mattinglot/malenki-nano/hardware/README.md

Hardware
====

Production hardware is in malenki-nanoi/

Panels are in panel*/
