mattinglot/malenki-nano/hardware/holder/malenki-holder.FCStd

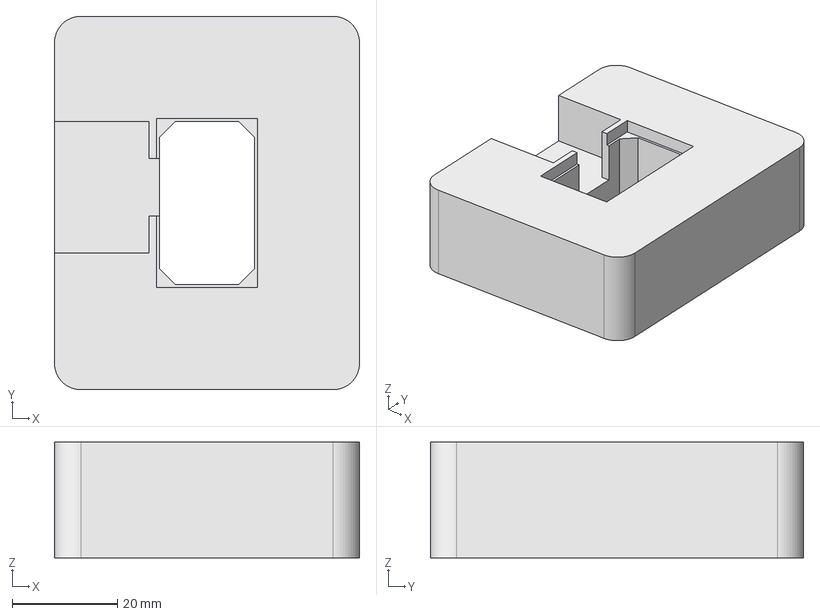
[picture p1: CAD file, 2024-02-17]
hardware/holder/malenki-holder.FCStd
58.0 x 71.0 x 22.0 mm
