mattinglot/malenki-nano/hardware/malenki-1616-3A/malenki-1616-3A.step

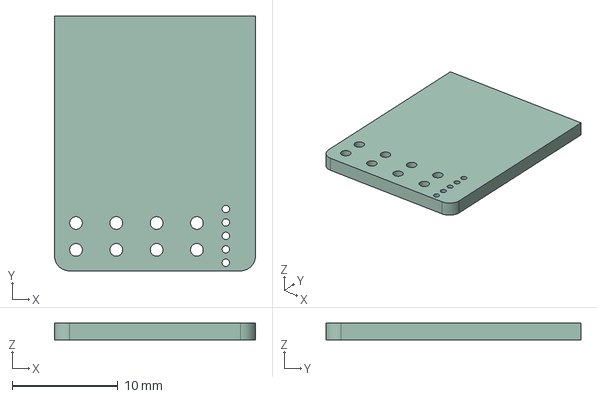
[picture p2: CAD file, 2024-01-25]
hardware/malenki-1616-3A/malenki-1616-3A.step
19.0 x 24.1 x 1.60 mm
