mattinglot/malenki-nano/(list of files, cad)

Other CAD files:
hardware/malenki-1616-3A/malenki-1616-3A.obj
