mattinglot/malenki-nano/hardware/malenki-1616-3A/change_log.md

# Design Revisions and Rationale

## 2202-08-27
Changes by: Matt Inglot

- Added XLR 0.1uF bypass caps between VM and GND on drivers per DRV8212P datasheet recommendations (p 26).
