mattinglot/malenki-nano/hardware/malenki-1616-3A/malenki-1616-3A.kicad_pcb

## KiCad design hardware/malenki-1616-3A/malenki-1616-3A.kicad_pcb (2024-01-25)

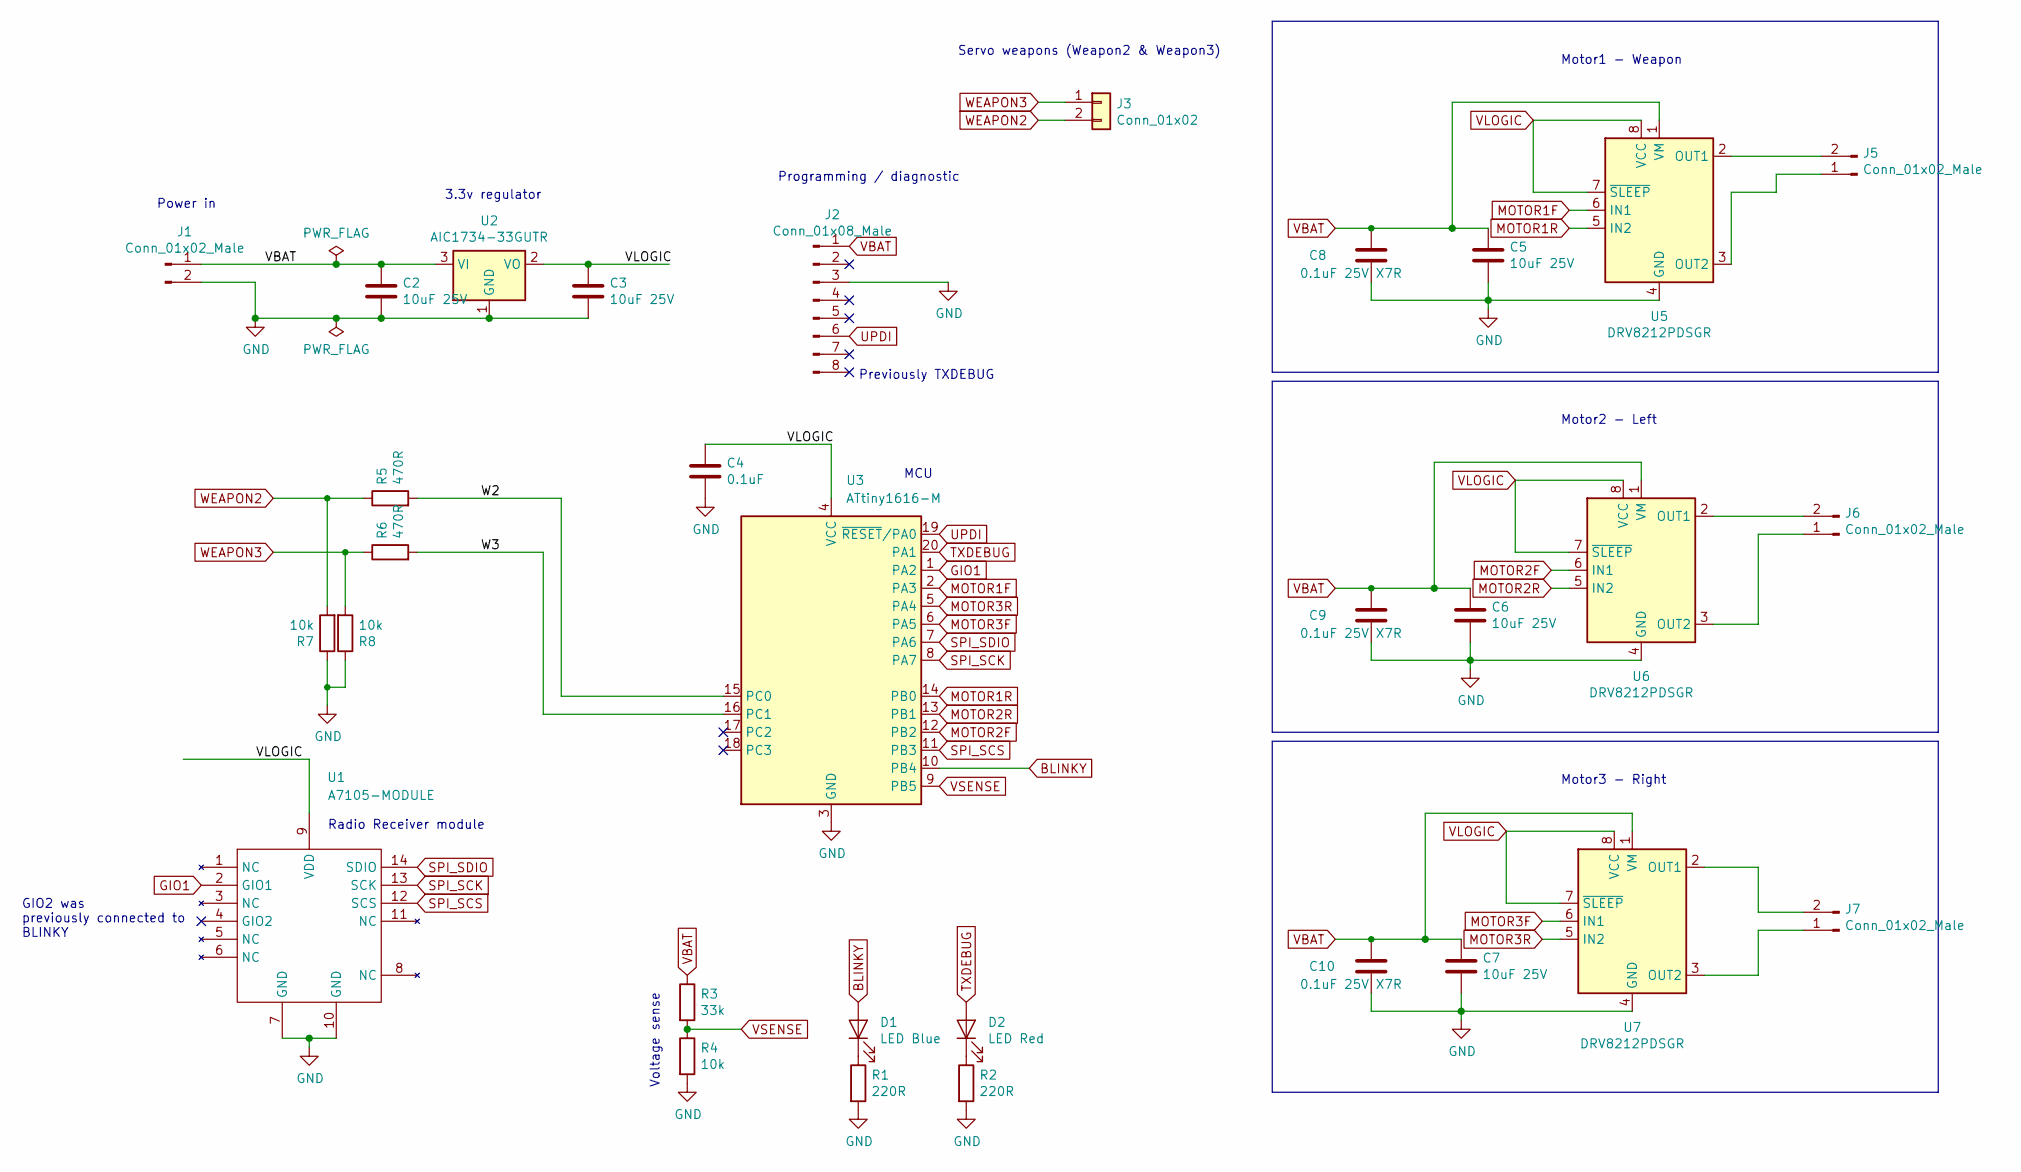
[picture p3: schematic malenki-1616-3A.kicad_sch, Malenki-Nano2]

Parts:
C2, C3, C5, C6, C7: 10uF 25V; C_0603_1608Metric; LCSC C2922482
C4: 0.1uF; C_0603_1608Metric; Partnum C14663; LCSC C14663
C8, C9, C10: 0.1uF 25V X7R; C_0603_1608Metric; LCSC C2922482
D1: LED Blue; LED_0805_2012Metric_Pad1.15x1.40mm_HandSolder; LCSC C2293
D2: LED Red; LED_0805_2012Metric_Pad1.15x1.40mm_HandSolder; LCSC C84256
J1, J5, J6, J7: Conn_01x02_Male; PinHeader_1x02_P2.54mm_BIG1
J2: Conn_01x08_Male; SOIC_clipProgSmall
J3: Conn_01x02; wirepad_2
R1, R2: 220R; R_0603_1608Metric; Partnum C22962; LCSC C22962
R3: 33k; R_0603_1608Metric; Partnum C4216; LCSC C4216
R4: 10k; R_0603_1608Metric; Partnum C25804; LCSC C25804
R5, R6: 470R; R_0402_1005Metric; LCSC C25117
R7, R8: 10k; R_0402_1005Metric; LCSC C25744
U1: A7105-MODULE; A7105-module
U2: AIC1734-33GUTR; SOT-23; Partnum C211659; LCSC C211659
U3: ATtiny1616-M; VQFN-20-1EP_3x3mm_P0.4mm_EP1.7x1.7mm; LCSC C507118
U5, U6, U7: DRV8212PDSGR; WSON-8-1EP_2x2mm_P0.5mm_HAND1; LCSC C39159

Connections:
/W2: R5.2, U3.15 (PC0)
/W3: R6.2, U3.16 (PC1)
BLINKY: D1.2 (A), U3.10 (PB4)
GIO1: U1.2 (GIO1), U3.1 (PA2)
GND: C2.2, C3.2, C4.2, C5.2, C6.2, C7.2, C8.2, C9.2, C10.2, J1.2, J2.3, R1.2, R2.2, R4.2, R7.1, R8.1, U1.7 (GND), U1.10 (GND), U2.1 (GND), U3.3 (GND), U3.21 (GND), U5.4 (GND), U5.9 (GND), U6.4 (GND), U6.9 (GND), U7.4 (GND), U7.9 (GND)
MOTOR1F: U3.2 (PA3), U5.6 (IN1)
MOTOR1R: U3.14 (PB0), U5.5 (IN2)
MOTOR2F: U3.12 (PB2), U6.6 (IN1)
MOTOR2R: U3.13 (PB1), U6.5 (IN2)
MOTOR3F: U3.6 (PA5), U7.6 (IN1)
MOTOR3R: U3.5 (PA4), U7.5 (IN2)
unnamed: D1.1 (K), R1.1
unnamed: D2.1 (K), R2.1
unnamed: J5.1, U5.3 (OUT2)
unnamed: J5.2, U5.2 (OUT1)
unnamed: J6.1, U6.3 (OUT2)
unnamed: J6.2, U6.2 (OUT1)
unnamed: J7.1, U7.3 (OUT2)
unnamed: J7.2, U7.2 (OUT1)
SPI_SCK: U1.13 (SCK), U3.8 (PA7)
SPI_SCS: U1.12 (SCS), U3.11 (PB3)
SPI_SDIO: U1.14 (SDIO), U3.7 (PA6)
TXDEBUG: D2.2 (A), U3.20 (PA1)
UPDI: J2.6, U3.19 (~RESET/PA0)
VBAT: C2.1, C5.1, C6.1, C7.1, C8.1, C9.1, C10.1, J1.1, J2.1, R3.1, U2.3 (VI), U5.1 (VM), U6.1 (VM), U7.1 (VM)
VLOGIC: C3.1, C4.1, U1.9 (VDD), U2.2 (VO), U3.4 (VCC), U5.7 (~SLEEP), U5.8 (VCC), U6.7 (~SLEEP), U6.8 (VCC), U7.7 (~SLEEP), U7.8 (VCC)
VSENSE: R3.2, R4.1, U3.9 (PB5)
WEAPON2: J3.2, R5.1, R7.2
WEAPON3: J3.1, R6.1, R8.2

Notes on the sheet:
Voltage sense
MCU
GIO2 was previously connected to BLINKY
3.3v regulator
Programming / diagnostic
Motor3 - Right
Servo weapons (Weapon2 & Weapon3)
Motor1 - Weapon
Motor2 - Left
Power in
Radio Receiver module
Previously TXDEBUG

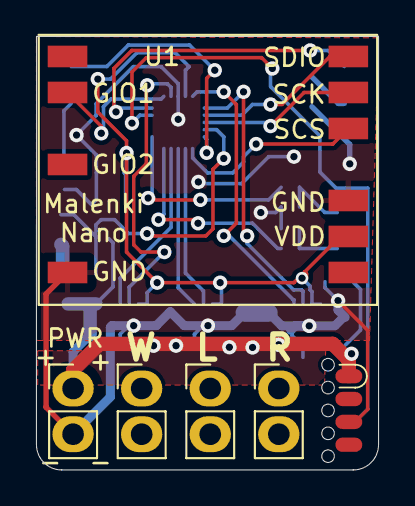
[picture p4: board malenki-1616-3A.kicad_pcb from above]

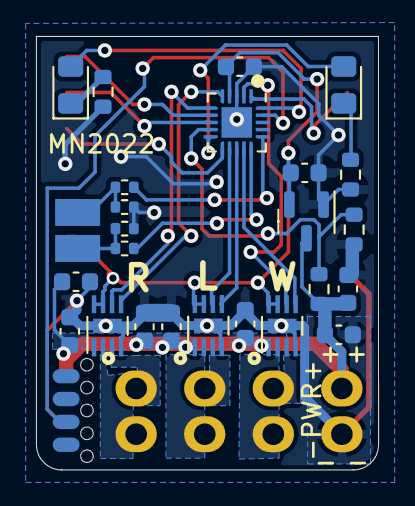
[picture p5: board malenki-1616-3A.kicad_pcb from below]

Board: 2 copper layers, 19.0 x 24.1 mm, 31 parts (25 on the bottom side), 29 nets.
