mattinglot/malenki-nano/hardware/malenki-hv/malenki-hv.kicad_pcb

## KiCad design hardware/malenki-hv/malenki-hv.kicad_pcb (2024-02-17)

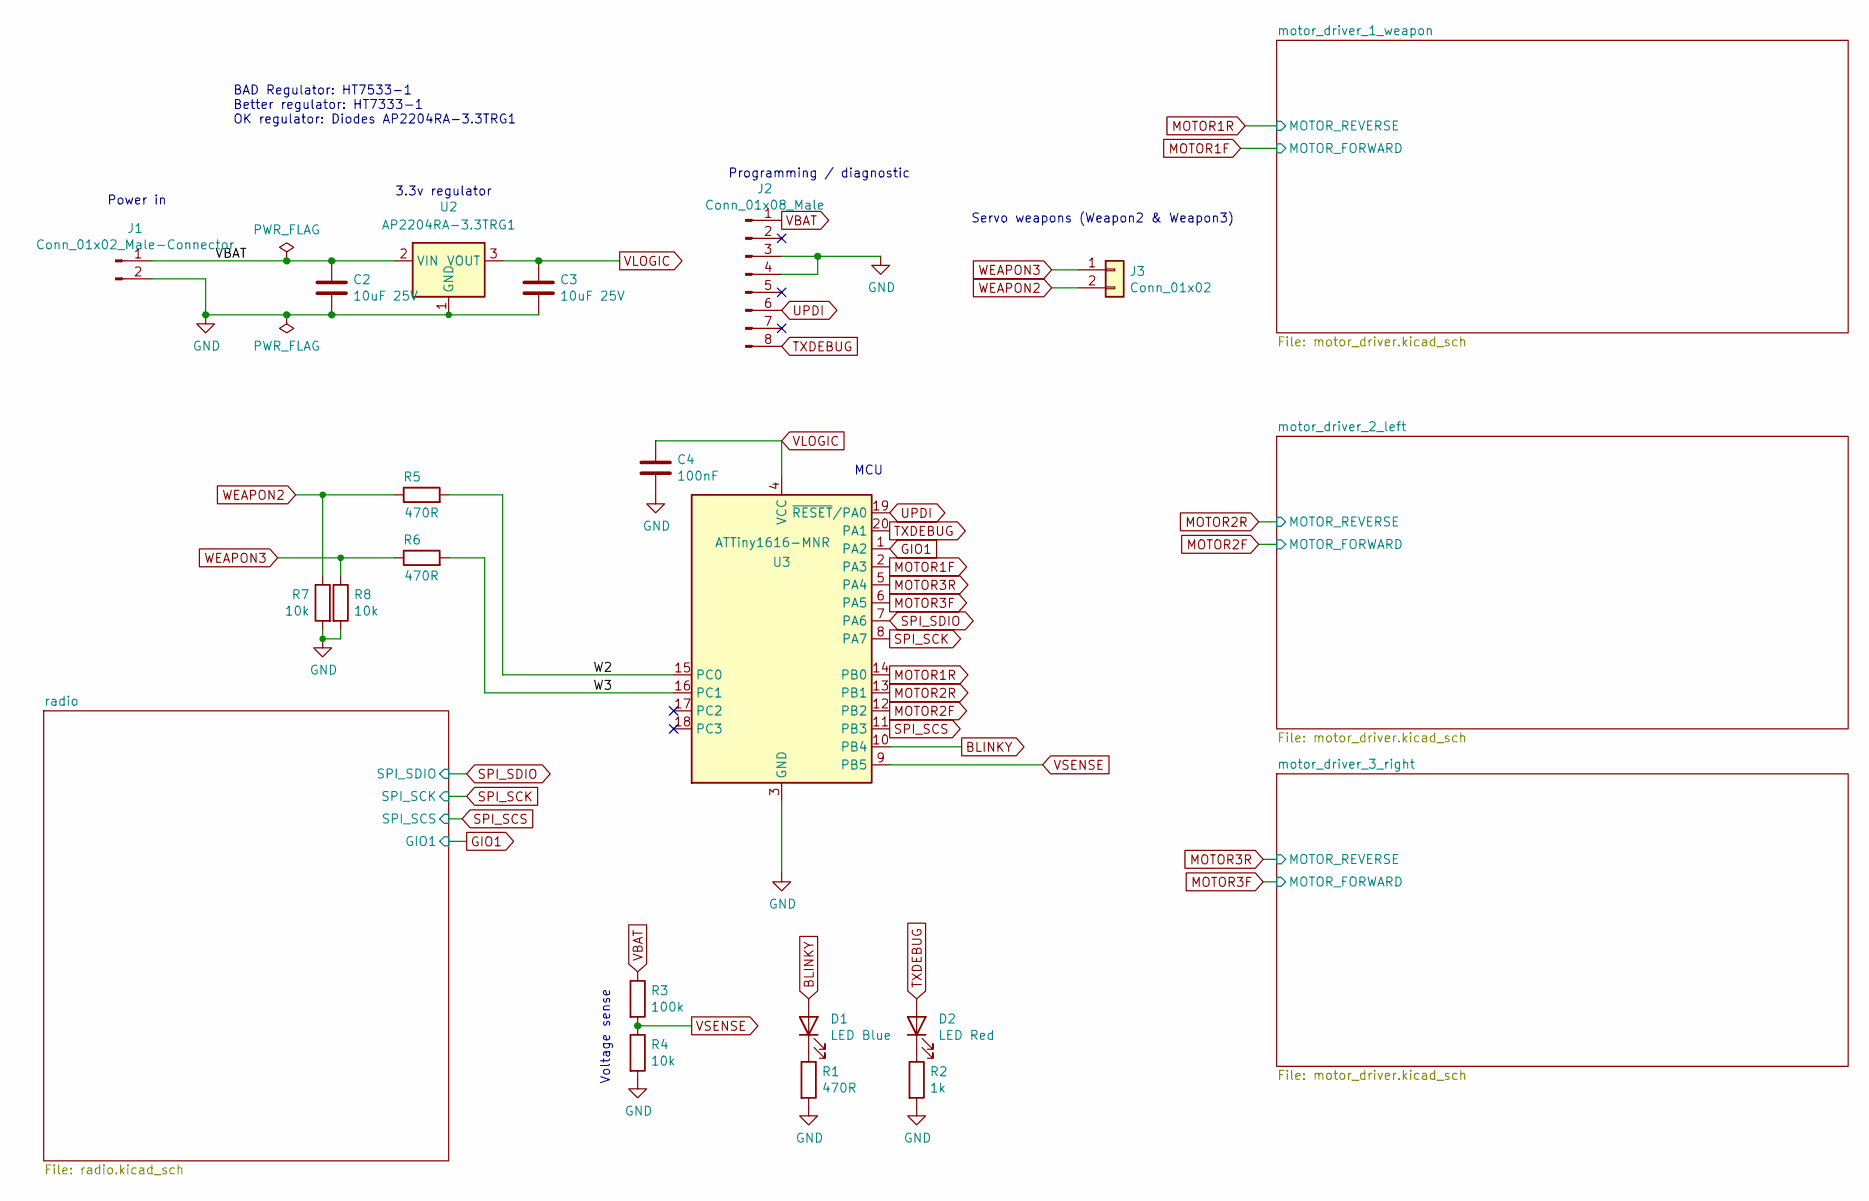
[picture p6: schematic malenki-hv.kicad_sch]

Parts:
C2, C3: 10uF 25V; C_0603_1608Metric; LCSC C96446
C4: 100nF; C_0402_1005Metric_Pad0.74x0.62mm_HandSolder; Partnum C14663; LCSC C307331
D1: LED Blue; LED_0603_1608Metric; MPN 19-217/BHC-ZL1M2RY/3T; LCSC C72041
D2: LED Red; LED_0603_1608Metric; MPN KT-0603R; LCSC C2286
J1: Conn_01x02_Male-Connector; malenkipower
J2: Conn_01x08_Male; SOIC_clipProgSmall
J3: Conn_01x02; wirepad_2
R1, R5, R6: 470R; R_0402_1005Metric; LCSC C25117
R2: 1k; R_0402_1005Metric; LCSC C11702
R3: 100k; R_0402_1005Metric; LCSC C25741
R4, R7, R8: 10k; R_0402_1005Metric; Partnum C25804; LCSC C25744
U2: AP2204RA-3.3TRG1; SOT-89-3; LCSC C151625
U3: ATTiny1616-MNR; VQFN-20-1EP_3x3mm_P0.4mm_EP1.7x1.7mm; MPN ATtiny1616-MNR; LCSC C507118

Connections:
/W2: R5.2, U3.15 (PC0)
/W3: R6.2, U3.16 (PC1)
BLINKY: D1.2 (A), U3.10 (PB4)
GIO1: U3.1 (PA2); also elsewhere on the board
GND: C2.2, C3.2, C4.2, J1.2, J2.3, J2.4, R1.2, R2.2, R4.2, R7.2, R8.2, U2.1 (GND), U3.3 (GND), U3.21 (GND); also elsewhere on the board
MOTOR1F: U3.2 (PA3); also elsewhere on the board
MOTOR1R: U3.14 (PB0); also elsewhere on the board
MOTOR2F: U3.12 (PB2); also elsewhere on the board
MOTOR2R: U3.13 (PB1); also elsewhere on the board
MOTOR3F: U3.6 (PA5); also elsewhere on the board
MOTOR3R: U3.5 (PA4); also elsewhere on the board
unnamed: D1.1 (K), R1.1
unnamed: D2.1 (K), R2.1
SPI_SCK: U3.8 (PA7); also elsewhere on the board
SPI_SCS: U3.11 (PB3); also elsewhere on the board
SPI_SDIO: U3.7 (PA6); also elsewhere on the board
TXDEBUG: D2.2 (A), J2.8, U3.20 (PA1)
UPDI: J2.6, U3.19 (~RESET/PA0)
VBAT: C2.1, J1.1, J2.1, R3.1, U2.2 (VIN); also elsewhere on the board
VLOGIC: C3.1, C4.1, U2.3 (VOUT), U3.4 (VCC); also elsewhere on the board
VSENSE: R3.2, R4.1, U3.9 (PB5)
WEAPON2: J3.2, R5.1, R7.1
WEAPON3: J3.1, R6.1, R8.1

Notes on the sheet:
Voltage sense
Power in
Servo weapons (Weapon2 & Weapon3)
Programming / diagnostic
BAD Regulator: HT7533-1 Better regulator: HT7333-1 OK regulator: Diodes AP2204RA-3.3TRG1
MCU
3.3v regulator

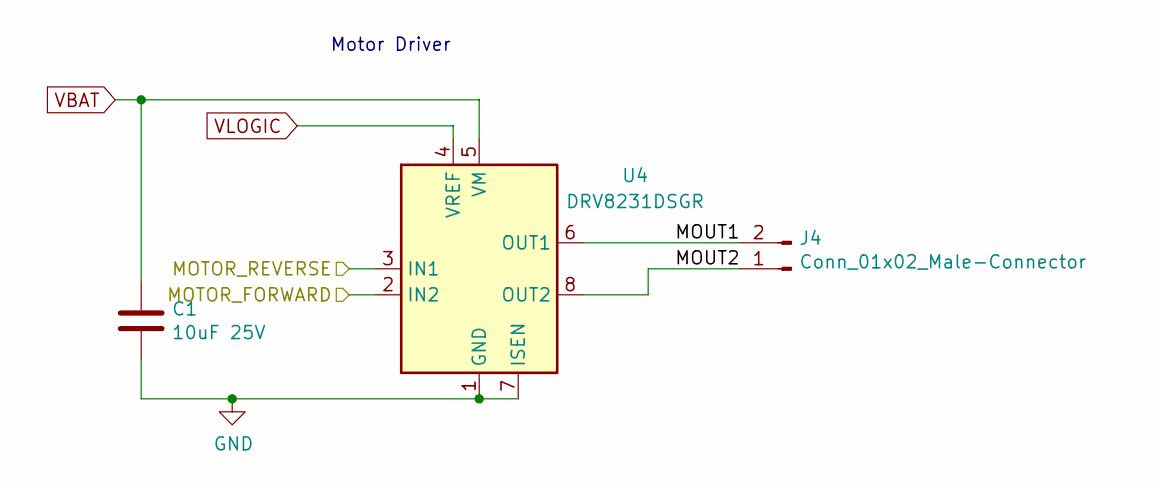
[picture p7: schematic motor_driver.kicad_sch]

Parts:
C1: 10uF 25V; C_0603_1608Metric; LCSC C96446
J4: Conn_01x02_Male-Connector; PinHeader_1x02_P2.54mm_BIG1
U4: DRV8231DSGR; WSON-8-1EP_2x2mm_P0.5mm_EP0.9x1.6mm; LCSC C3681197

Connections:
/motor_driver_1_weapon/MOUT1: J4.2, U4.6 (OUT1)
/motor_driver_1_weapon/MOUT2: J4.1, U4.8 (OUT2)
GND: C1.2, U4.1 (GND), U4.7 (ISEN), U4.9 (GND); also elsewhere on the board
MOTOR1F: U4.2 (IN2); also elsewhere on the board
MOTOR1R: U4.3 (IN1); also elsewhere on the board
VBAT: C1.1, U4.5 (VM); also elsewhere on the board
VLOGIC: U4.4 (VREF); also elsewhere on the board

Parts of its further copies:
C5, C6: 10uF 25V; C_0603_1608Metric; LCSC C96446
J5, J6: Conn_01x02_Male-Connector; PinHeader_1x02_P2.54mm_BIG1
U5, U6: DRV8231DSGR; WSON-8-1EP_2x2mm_P0.5mm_EP0.9x1.6mm; LCSC C3681197

Connections of its further copies:
/motor_driver_2_left/MOUT1: J5.2, U5.6 (OUT1)
/motor_driver_2_left/MOUT2: J5.1, U5.8 (OUT2)
/motor_driver_3_right/MOUT1: J6.2, U6.6 (OUT1)
/motor_driver_3_right/MOUT2: J6.1, U6.8 (OUT2)
GND: C5.2, C6.2, U5.1 (GND), U5.7 (ISEN), U5.9 (GND), U6.1 (GND), U6.7 (ISEN), U6.9 (GND); also elsewhere on the board
MOTOR2F: U5.2 (IN2); also elsewhere on the board
MOTOR2R: U5.3 (IN1); also elsewhere on the board
MOTOR3F: U6.2 (IN2); also elsewhere on the board
MOTOR3R: U6.3 (IN1); also elsewhere on the board
VBAT: C5.1, C6.1, U5.5 (VM), U6.5 (VM); also elsewhere on the board
VLOGIC: U5.4 (VREF), U6.4 (VREF); also elsewhere on the board

Notes on the sheet:
Motor Driver

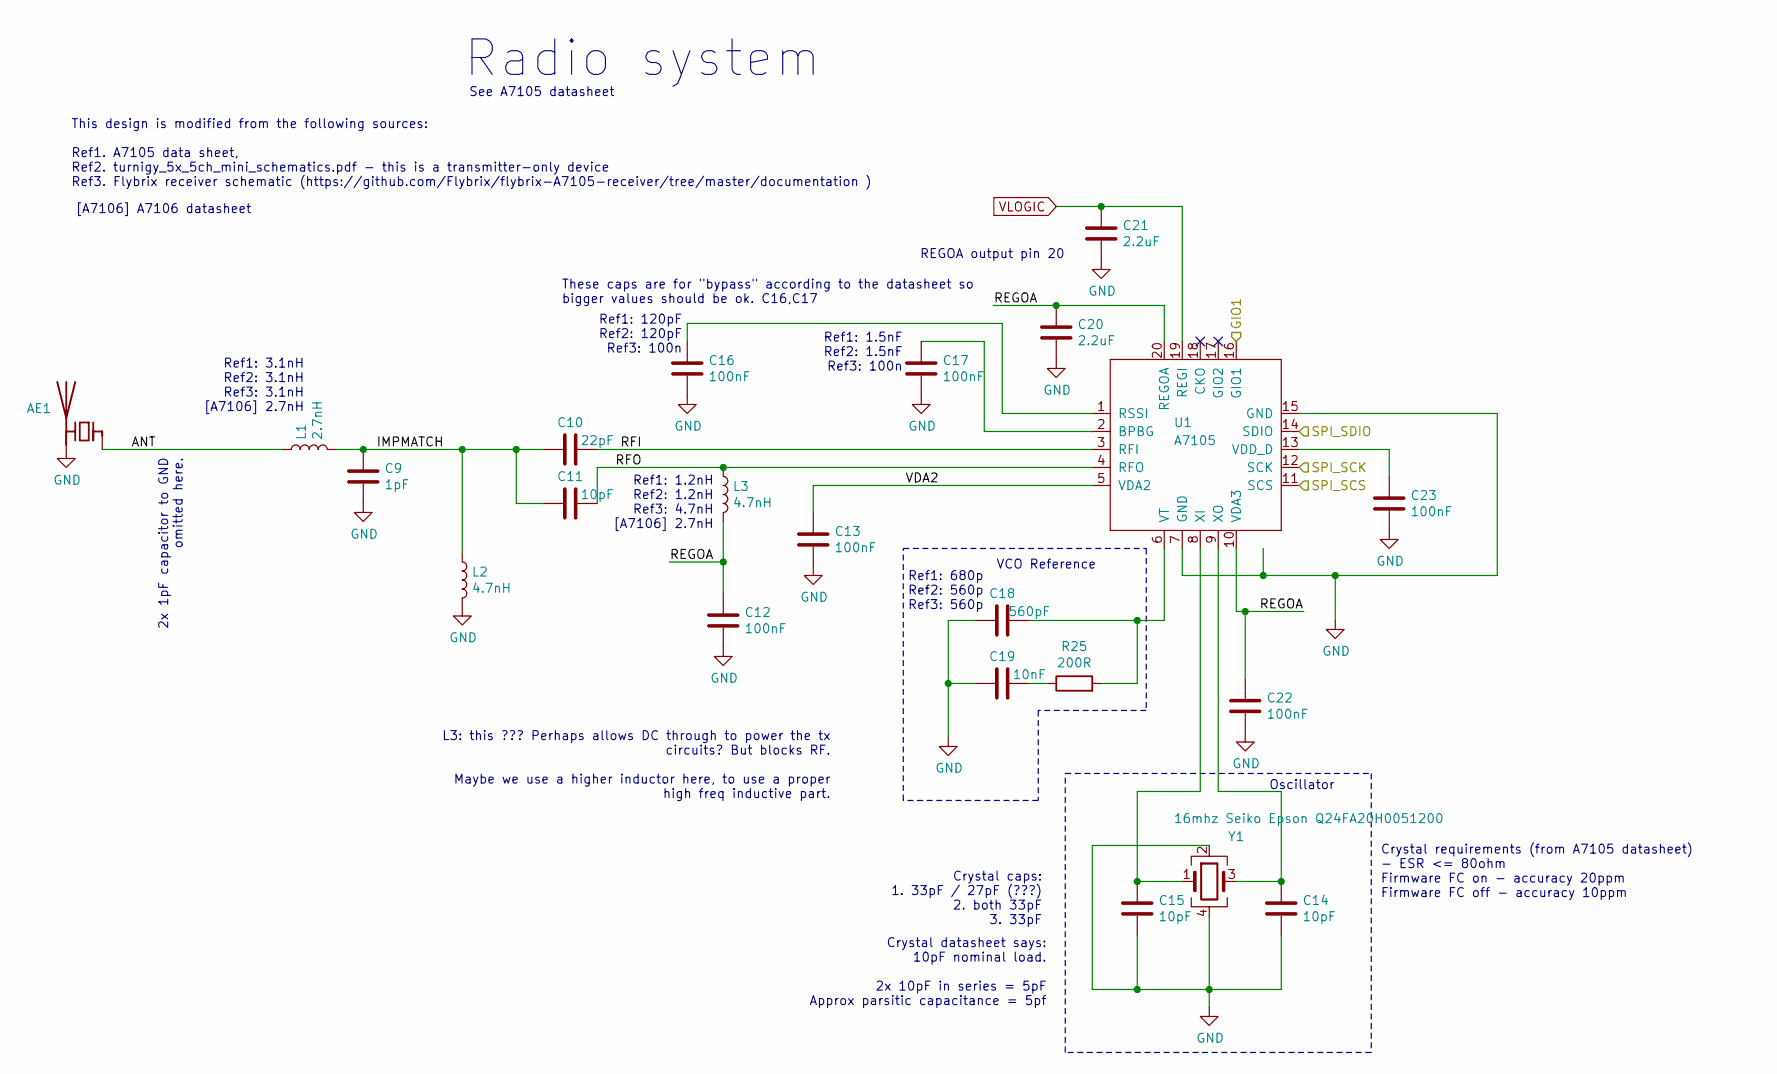
[picture p8: schematic radio.kicad_sch]

Parts:
AE1: malenki_antenna
C9: 1pF; C_0402_1005Metric_Pad0.74x0.62mm_HandSolder; MPN 0402CG1R0C500NT; LCSC C1550
C10: 22pF; C_0402_1005Metric_Pad0.74x0.62mm_HandSolder; MPN 0402CG220J500NT; LCSC C1555
C11, C14, C15: 10pF; C_0402_1005Metric_Pad0.74x0.62mm_HandSolder; MPN CL05C100JB5NNNC; LCSC C32949
C12, C13, C16, C17, C22, C23: 100nF; C_0402_1005Metric_Pad0.74x0.62mm_HandSolder; LCSC C307331
C18: 560pF; C_0402_1005Metric_Pad0.74x0.62mm_HandSolder; MPN CL05C561JB5NNNC; LCSC C1539
C19: 10nF; C_0402_1005Metric_Pad0.74x0.62mm_HandSolder; MPN CL05B103KB5NNNC; LCSC C15195
C20, C21: 2.2uF; C_0603_1608Metric; MPN CL05A225MQ5NSNC; LCSC C23630
L1: 2.7nH; L_0402_1005Metric_Pad0.77x0.64mm_HandSolder; LCSC C76791
L2: 4.7nH; L_0402_1005Metric_Pad0.77x0.64mm_HandSolder; MPN LQW15AN4N7D10D; LCSC C341688
L3: 4.7nH; L_0402_1005Metric_Pad0.77x0.64mm_HandSolder; MPN VHF160808H4N7ST; LCSC C341688
R25: 200R; R_0402_1005Metric; MPN 0402WGF2000TCE; LCSC C25087
U1: A7105; a7105-QFN-20; MPN A71X05AQFI/Q; LCSC C126376
Y1: 16mhz Seiko Epson Q24FA20H0051200; Crystal_SMD_2520-4Pin_2.5x2.0mm; MPN Q24FA20H0051200; LCSC C255947

Connections:
/radio/ANT: AE1.1 (FEED), L1.1
/radio/IMPMATCH: C9.1, C10.1, C11.1, L1.2, L2.1
/radio/REGOA: C12.1, C20.1, C22.1, L3.2, U1.10 (VDA3), U1.20 (REGOA)
/radio/RFI: C10.2, U1.3 (RFI)
/radio/RFO: C11.2, L3.1, U1.4 (RFO)
/radio/VDA2: C13.1, U1.5 (VDA2)
GIO1: U1.16 (GIO1); also elsewhere on the board
GND: AE1.2 (PCB_Trace), C9.2, C12.2, C13.2, C14.2, C15.2, C16.2, C17.2, C18.1, C19.2, C20.2, C21.2, C22.2, C23.2, L2.2, U1.7 (GND), U1.15 (GND), U1.21 (GND), Y1.2, Y1.4; also elsewhere on the board
unnamed: C19.1, R25.1
unnamed: C17.1, U1.2 (BPBG)
unnamed: C16.1, U1.1 (RSSI)
unnamed: C23.1, U1.13 (VDD_D)
unnamed: C18.2, R25.2, U1.6 (VT)
unnamed: C15.1, U1.8 (XI), Y1.1
unnamed: C14.1, U1.9 (XO), Y1.3
SPI_SCK: U1.12 (SCK); also elsewhere on the board
SPI_SCS: U1.11 (SCS); also elsewhere on the board
SPI_SDIO: U1.14 (SDIO); also elsewhere on the board
VLOGIC: C21.1, U1.19 (REGI); also elsewhere on the board

Notes on the sheet:
REGOA output pin 20
Radio system
Ref1: 3.1nH Ref2: 3.1nH Ref3: 3.1nH [A7106] 2.7nH
See A7105 datasheet
Ref1: 120pF Ref2: 120pF Ref3: 100n
Crystal datasheet says: 10pF nominal load. 2x 10pF in series = 5pF Approx parsitic capacitance = 5pf
Oscillator
Ref1: 1.2nH Ref2: 1.2nH Ref3: 4.7nH [A7106] 2.7nH
L3: this ??? Perhaps allows DC through to power the tx circuits? But blocks RF. Maybe we use a higher inductor here, to use a proper high freq inductive part.
Crystal requirements (from A7105 datasheet) - ESR <= 80ohm Firmware FC on - accuracy 20ppm Firmware FC off - accuracy 10ppm
[A7106] A7106 datasheet
These caps are for "bypass" according to the datasheet so bigger values should be ok. C16,C17
Ref1: 680p Ref2: 560p Ref3: 560p
VCO Reference
2x 1pF capacitor to GND omitted here.
This design is modified from the following sources: Ref1. A7105 data sheet, Ref2. turnigy_5x_5ch_mini_schematics.pdf - this is a transmitter-only device Ref3. Flybrix receiver schematic (https://github.com/Flybrix/flybrix-A7105-receiver/tree/master/documentation )
Crystal caps: 1. 33pF / 27pF (???) 2. both 33pF 3. 33pF
Ref1: 1.5nF Ref2: 1.5nF Ref3: 100n

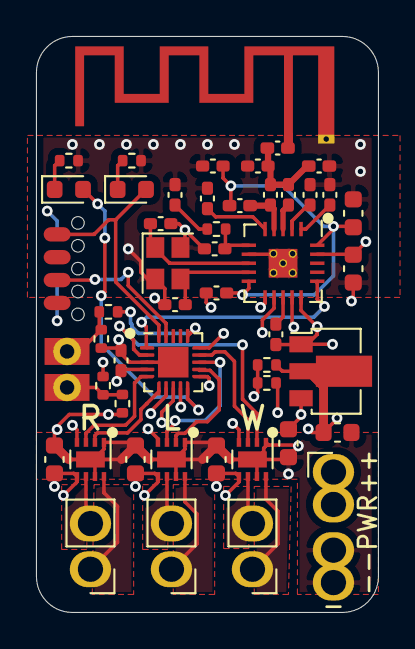
[picture p9: board malenki-hv.kicad_pcb from above]

Board: 4 copper layers, 19.0 x 32.0 mm, 49 parts (1 on the bottom side), 42 nets.
