mattinglot/malenki-nano/(commit log)

2022-08-27 3A version of malenki-1616 Changed motor driver to use DRV8212PDSGR in order to support 3A current rating (4A peak) Added 0.1uf caps on motor drivers per Ti datasheet.
    [malenki-1616-3A.kicad_pcb, malenki-1616-3A.kicad_sch, malenki-1616-updated.csv]
2022-08-30 Updated PCB layout to support the additional capacitors and increased trace width where possible for GND to support the higher current.
    [malenki-1616-3A.kicad_pcb]
2022-08-30 Added vias to motor driver thermal pads to sink heat into front layer copper.
    [malenki-1616-3A.kicad_pcb]
2024-01-25 Completed modded Malenki
    [malenki-1616-3A-B_Cu.gbl, malenki-1616-3A-B_Mask.gbs, malenki-1616-3A-B_Paste.gbp, malenki-1616-3A-B_Silkscreen.gbo, malenki-1616-3A-Edge_Cuts.gm1, malenki-1616-3A-F_Cu.gtl, malenki-1616-3A-F_Mask.gts, malenki-1616-3A-F_Paste.gtp]
